RealTaseny/lidar_camera_sync_hardware/3D_Models/SPM7054VT-100M-D.step

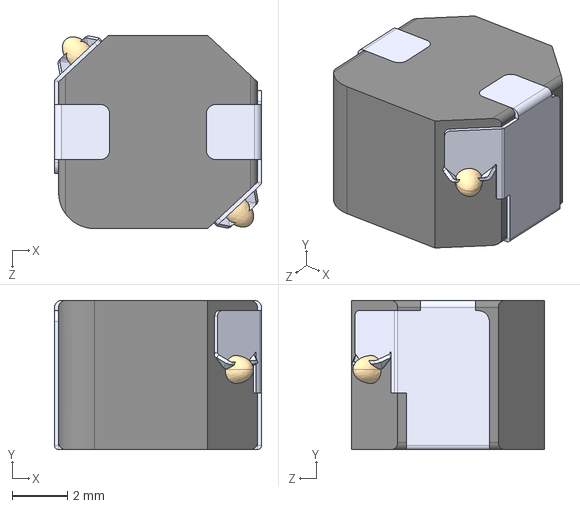
[picture p1: CAD file, 2025-11-24]
3D_Models/SPM7054VT-100M-D.step
7.50 x 5.40 x 7.00 mm
