RealTaseny/lidar_camera_sync_hardware/3D_Models/AMS1117-5.0.step

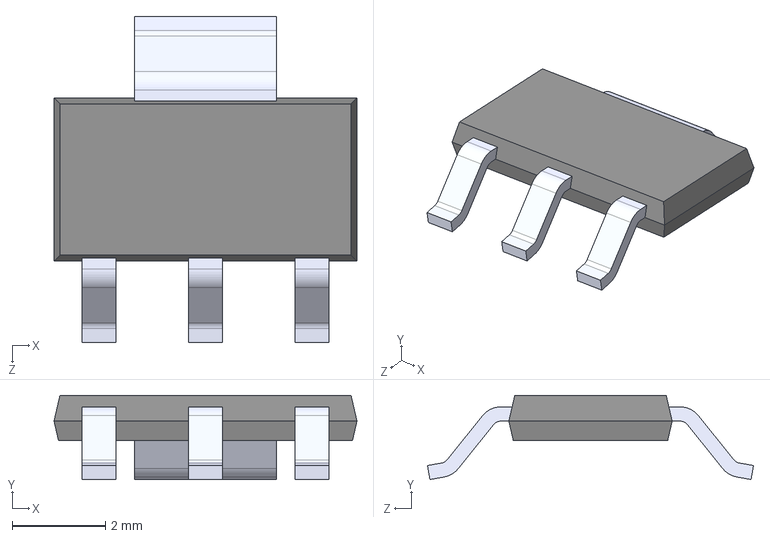
[picture p2: CAD file, 2025-11-24]
3D_Models/AMS1117-5.0.step
6.50 x 1.80 x 7.00 mm
