RealTaseny/lidar_camera_sync_hardware/3D_Models/BM08B-GHS-TBT_LF__SN__N_.step

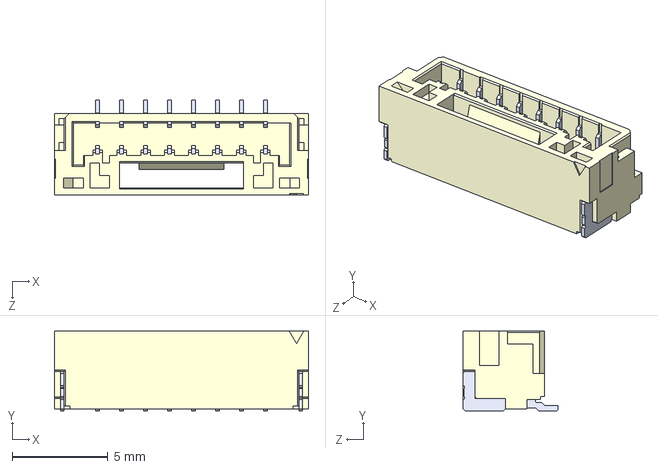
[picture p3: CAD file, 2025-11-24]
3D_Models/BM08B-GHS-TBT_LF__SN__N_.step
13.2 x 4.15 x 4.95 mm
