RealTaseny/lidar_camera_sync_hardware/3D_Models/RT9013-33GB.step

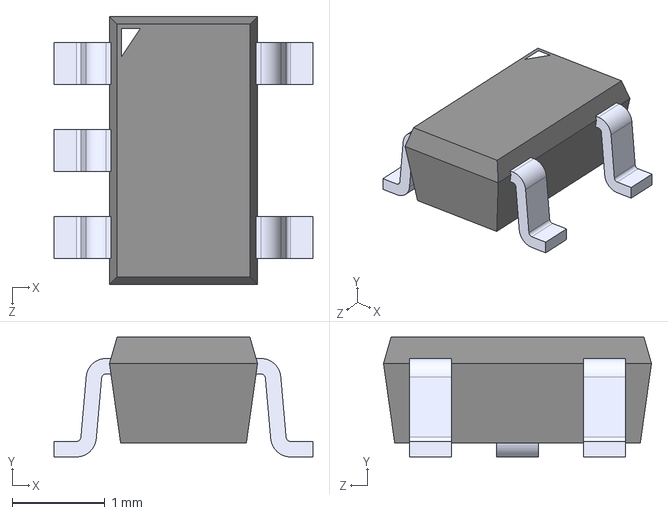
[picture p4: CAD file, 2025-11-24]
3D_Models/RT9013-33GB.step
2.79 x 1.30 x 2.90 mm
