RealTaseny/lidar_camera_sync_hardware/3D_Models/STM32G431KBU3.step

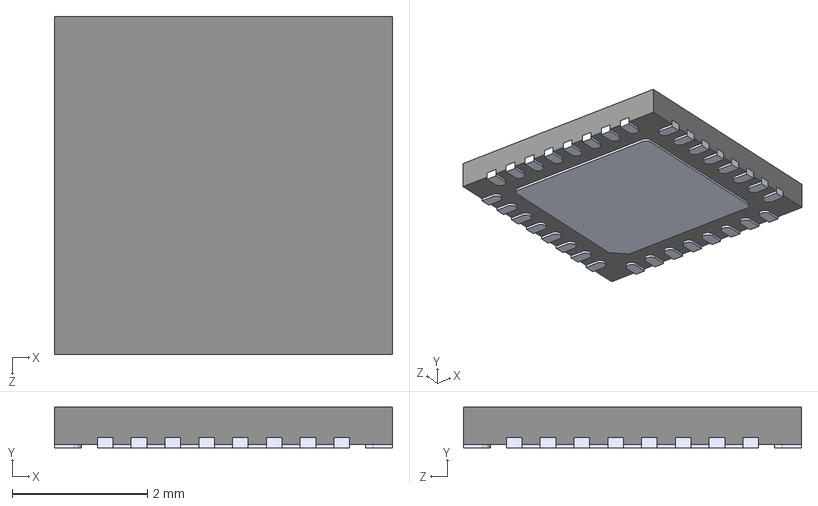
[picture p5: CAD file, 2025-11-24]
3D_Models/STM32G431KBU3.step
5.00 x 0.6 x 5.00 mm
