RealTaseny/lidar_camera_sync_hardware/3D_Models/TS-1088-AR02016.step

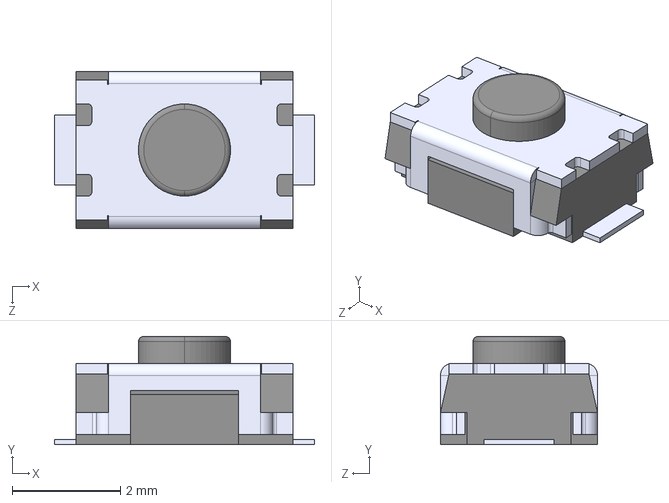
[picture p6: CAD file, 2025-11-24]
3D_Models/TS-1088-AR02016.step
4.80 x 2.00 x 2.90 mm
