RealTaseny/lidar_camera_sync_hardware/3D_Models/MAX3232ESE.step

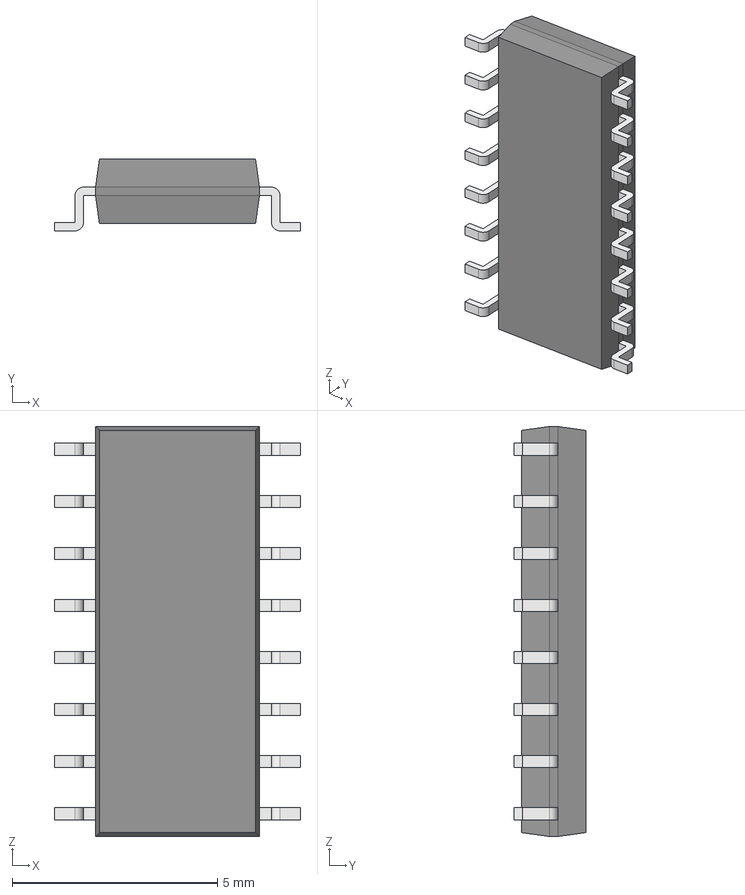
[picture p7: CAD file, 2025-11-24]
3D_Models/MAX3232ESE.step
6.00 x 1.75 x 10.0 mm
Body001 (Mirror #1) x 8
XY-plane x 12
X-axis x 12
