RealTaseny/lidar_camera_sync_hardware/3D_Models/TPS54560DDAR.step

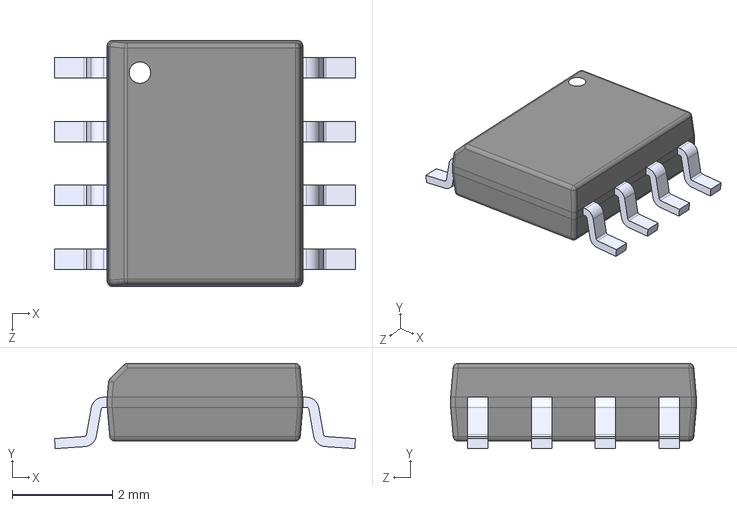
[picture p8: CAD file, 2025-11-24]
3D_Models/TPS54560DDAR.step
6.00 x 1.70 x 4.90 mm
