RealTaseny/lidar_camera_sync_hardware/3D_Models/ISO7720D.step

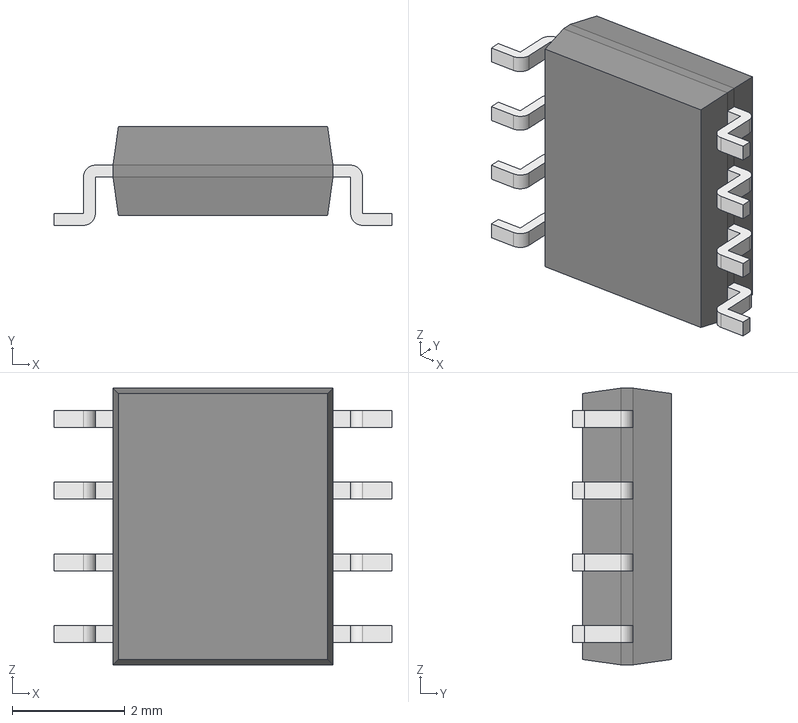
[picture p9: CAD file, 2025-11-24]
3D_Models/ISO7720D.step
5.99 x 1.75 x 4.91 mm
Body001 (Mirror #1) x 4
XY-plane x 12
X-axis x 12
