RealTaseny/lidar_camera_sync_hardware/3D_Models/X32258MOB4SI.step

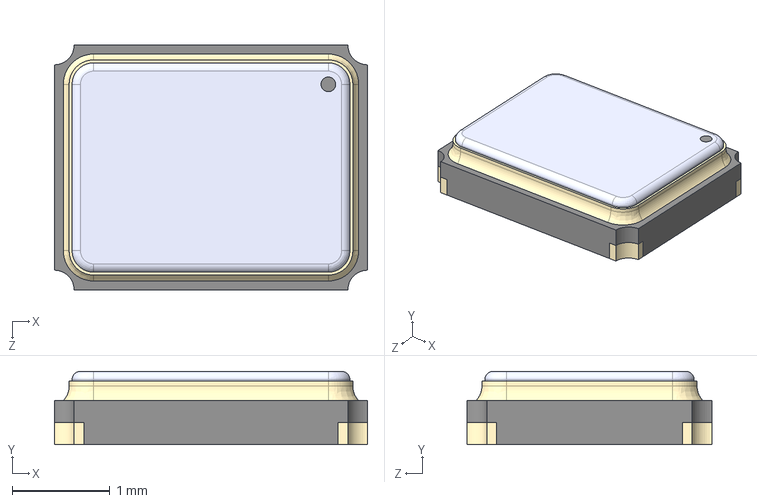
[picture p10: CAD file, 2025-11-24]
3D_Models/X32258MOB4SI.step
3.20 x 0.75 x 2.50 mm
