RealTaseny/lidar_camera_sync_hardware/lidar_camera_sync.kicad_pcb

## KiCad design lidar_camera_sync.kicad_pcb (2025-11-25)

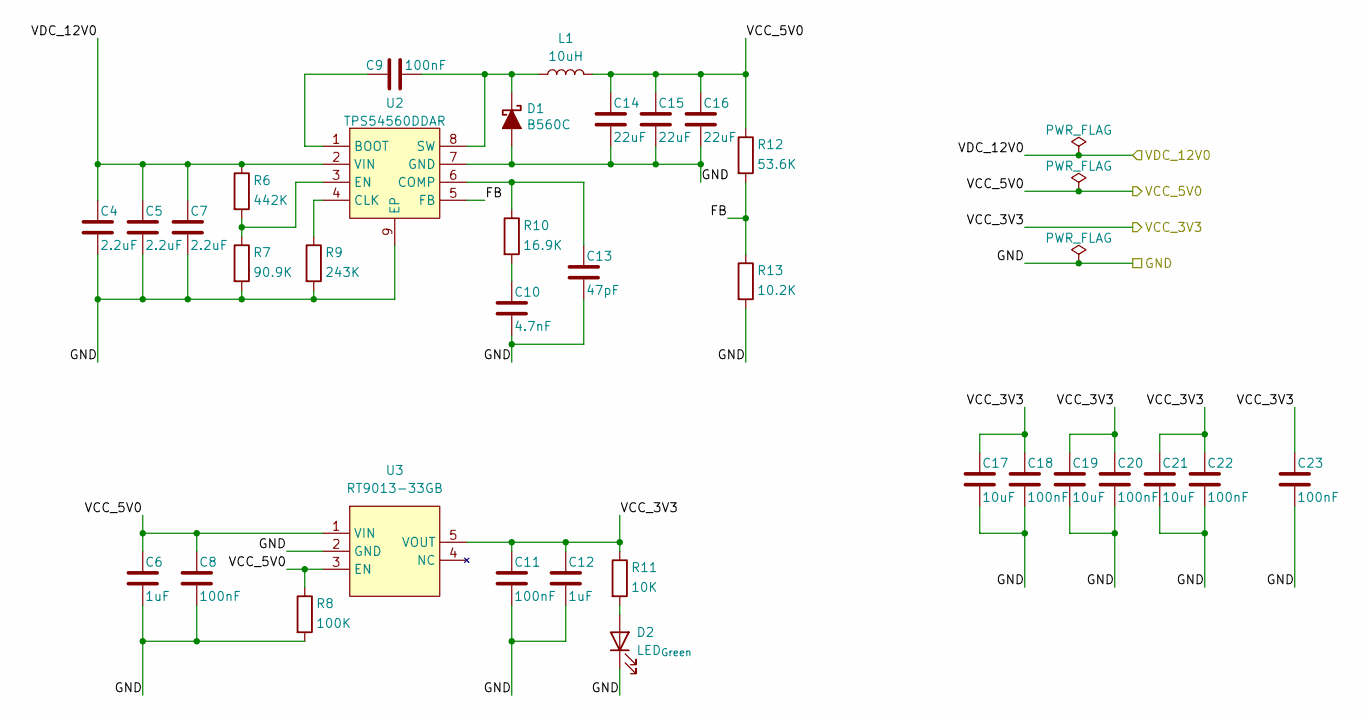
[picture p11: schematic Power.kicad_sch]

Parts:
C4, C5, C7: 2.2uF; C_0805_2012Metric
C6, C12: 1uF; C_0603_1608Metric
C8, C9, C11, C18, C20, C22, C23: 100nF; C_0603_1608Metric
C10: 4.7nF; C_0603_1608Metric
C13: 47pF; C_0603_1608Metric
C14, C15, C16: 22uF; C_0805_2012Metric
C17, C19, C21: 10uF; C_0603_1608Metric
D1: B560C; D_SMC
D2: LED_{Green}; LED_0603_1608Metric
L1: 10uH; SPM7054VT-100M-D
R6: 442K; R_0603_1608Metric
R7: 90.9K; R_0603_1608Metric
R8: 100K; R_0603_1608Metric
R9: 243K; R_0603_1608Metric
R10: 16.9K; R_0603_1608Metric
R11: 10K; R_0603_1608Metric
R12: 53.6K; R_0603_1608Metric
R13: 10.2K; R_0603_1608Metric
U2: TPS54560DDAR; SOIC8-4.9x5.4_P1.27
U3: RT9013-33GB; SOT-23-5

Connections:
/MCU/GND: C4.2, C5.2, C6.2, C7.2, C8.2, C10.2, C11.2, C12.2, C13.2, C14.2, C15.2, C16.2, C17.2, C18.2, C19.2, C20.2, C21.2, C22.2, C23.2, D1.2 (A), D2.1 (K), R7.2, R8.2, R9.2, R13.2, U2.7 (GND), U2.9 (EP), U3.2 (GND); also elsewhere on the board
/MCU/VCC_3V3: C11.1, C12.1, C17.1, C18.1, C19.1, C20.1, C21.1, C22.1, C23.1, R11.1, U3.5 (VOUT); also elsewhere on the board
/Peripheral/12V_CAMERA: C4.1, C5.1, C7.1, R6.1, U2.2 (VIN); also elsewhere on the board
/Peripheral/VCC_5V0: C6.1, C8.1, C14.1, C15.1, C16.1, L1.2, R8.1, R12.1, U3.1 (VIN), U3.3 (EN); also elsewhere on the board
/Power/FB: R12.2, R13.1, U2.5 (FB)
unnamed: C10.1, R10.2
unnamed: C9.2, D1.1 (K), L1.1, U2.8 (SW)
unnamed: D2.2 (A), R11.2
unnamed: C9.1, U2.1 (BOOT)
unnamed: R9.1, U2.4 (CLK)
unnamed: C13.1, R10.1, U2.6 (COMP)
unnamed: R6.2, R7.1, U2.3 (EN)

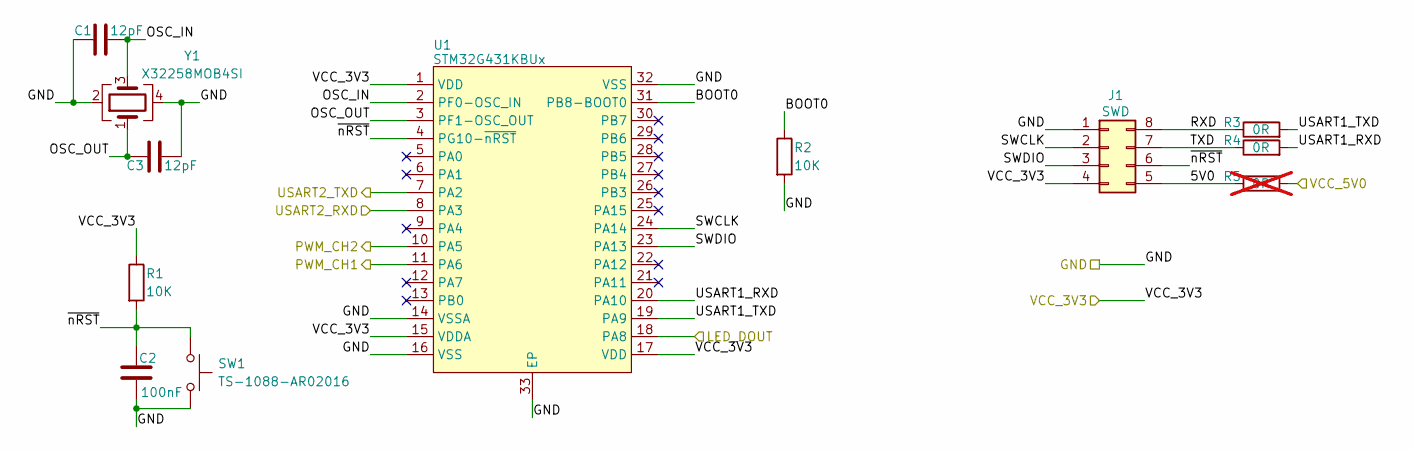
[picture p12: schematic MCU.kicad_sch]

Parts:
C1, C3: 12pF; C_0603_1608Metric
C2: 100nF; C_0603_1608Metric
J1: SWD; Pinheader_2x04_P2.54mm
R1, R2: 10K; R_0603_1608Metric
R3, R4: 0R; R_0603_1608Metric
R5: 0R; R_0603_1608Metric; not fitted
SW1: TS-1088-AR02016
U1: STM32G431KBUx; UFQFPN32-5.3x5.3_P0.5
Y1: X32258MOB4SI; SMD3225

Connections:
/MCU/5V0: J1.5, R5.1; also elsewhere on the board
/MCU/BOOT0: R2.1, U1.31 (PB8-BOOT0)
/MCU/GND: C1.2, C2.2, C3.1, J1.1, R2.2, SW1.2, U1.14 (VSSA), U1.16 (VSS), U1.32 (VSS), U1.33 (EP), Y1.2, Y1.4; also elsewhere on the board
/MCU/LED_DOUT: U1.18 (PA8); also elsewhere on the board
/MCU/OSC_IN: C1.1, U1.2 (PF0-OSC_IN), Y1.3
/MCU/OSC_OUT: C3.2, U1.3 (PF1-OSC_OUT), Y1.1
/MCU/PWM_CH1: U1.11 (PA6); also elsewhere on the board
/MCU/PWM_CH2: U1.10 (PA5); also elsewhere on the board
/MCU/RXD: J1.8, R3.1; also elsewhere on the board
/MCU/SWCLK: J1.2, U1.24 (PA14); also elsewhere on the board
/MCU/SWDIO: J1.3, U1.23 (PA13); also elsewhere on the board
/MCU/TXD: J1.7, R4.1; also elsewhere on the board
/MCU/USART1_RXD: R4.2, U1.20 (PA10)
/MCU/USART1_TXD: R3.2, U1.19 (PA9)
/MCU/USART2_RXD: U1.8 (PA3); also elsewhere on the board
/MCU/USART2_TXD: U1.7 (PA2); also elsewhere on the board
/MCU/VCC_3V3: J1.4, R1.1, U1.1 (VDD), U1.15 (VDDA), U1.17 (VDD); also elsewhere on the board
/MCU/~nRST: C2.1, J1.6, R1.2, SW1.1, U1.4 (PG10-~nRST); also elsewhere on the board
/Peripheral/VCC_5V0: R5.2; also elsewhere on the board

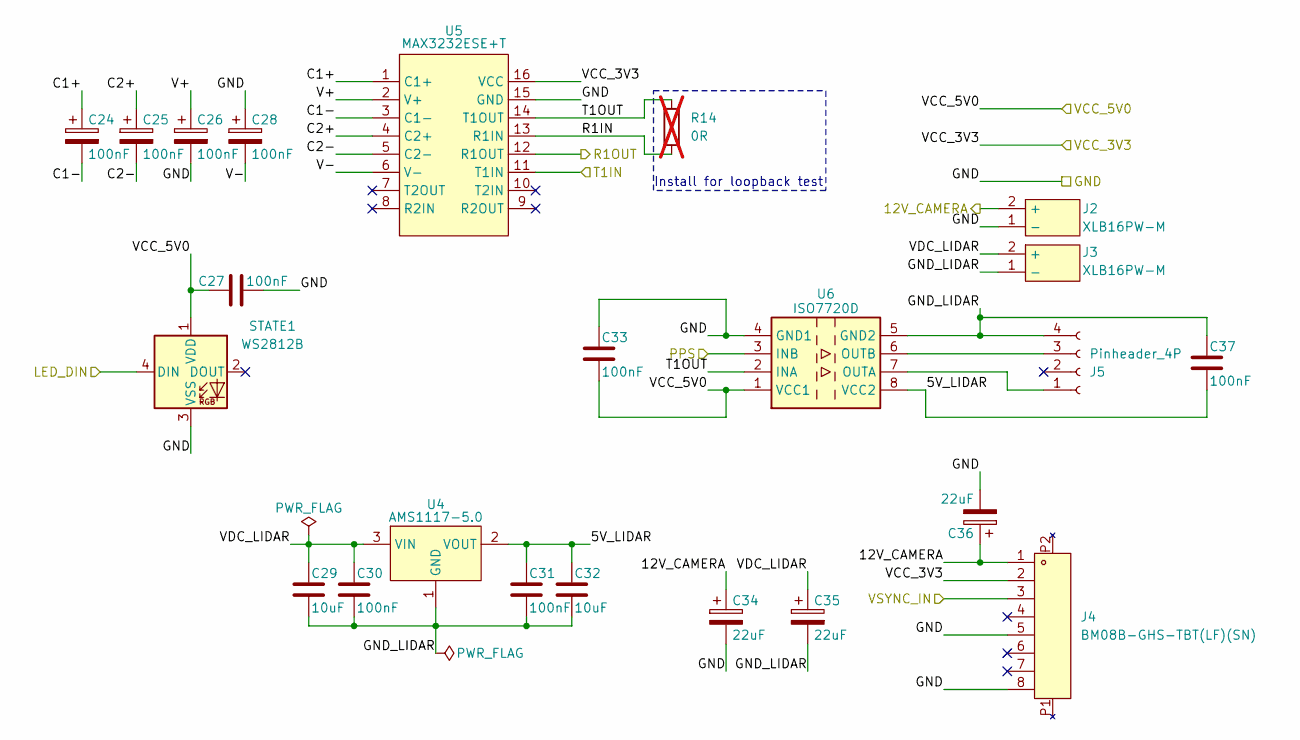
[picture p13: schematic Peripheral.kicad_sch]

Parts:
C24, C25, C26, C28: 100nF; CP_Elec_4x5.4
C27, C30, C31, C33, C37: 100nF; C_0603_1608Metric
C29, C32: 10uF; C_0603_1608Metric
C34, C35, C36: 22uF; CP_Elec_6.3x5.4
J2, J3: XLB16PW-M
J4: BM08B-GHS-TBT(LF)(SN); BM08B-GHS-TBT(LF)(SN)(N)
J5: Pinheader_4P; PinHeader_1x04_P2.54mm_Vertical
R14: 0R; R_0603_1608Metric; not fitted
STATE1: WS2812B; LED_WS2812B_PLCC4_5.0x5.0mm_P3.2mm
U4: AMS1117-5.0; SOT223
U5: MAX3232ESE+T; SOIC16-4.95x8.9_P1.27
U6: ISO7720D; SOIC8-4.9x5.4_P1.27_NO_EP

Connections:
/MCU/GND: C26.2, C27.2, C28.1, C33.1, C34.2, C36.2, J2.1 (-), J4.5, J4.8, STATE1.3 (VSS), U5.15 (GND), U6.4 (GND1); also elsewhere on the board
/MCU/PWM_CH1: U6.3 (INB); also elsewhere on the board
/MCU/PWM_CH2: J4.3; also elsewhere on the board
/MCU/USART2_RXD: U5.12 (R1OUT); also elsewhere on the board
/MCU/USART2_TXD: U5.11 (T1IN); also elsewhere on the board
/MCU/VCC_3V3: J4.2, U5.16 (VCC); also elsewhere on the board
/Peripheral/5V_LIDAR: C31.1, C32.1, C37.2, U4.2 (VOUT), U4.4 (VOUT), U6.8 (VCC2)
/Peripheral/12V_CAMERA: C34.1, C36.1, J4.1; also elsewhere on the board
/Peripheral/C1+: C24.1, U5.1 (C1+)
/Peripheral/C1-: C24.2, U5.3 (C1-)
/Peripheral/C2+: C25.1, U5.4 (C2+)
/Peripheral/C2-: C25.2, U5.5 (C2-)
/Peripheral/GND_LIDAR: C29.2, C30.2, C31.2, C32.2, C35.2, C37.1, J3.1 (-), J5.4, U4.1 (GND), U6.5 (GND2); also elsewhere on the board
/Peripheral/R1IN: R14.2, U5.13 (R1IN)
/Peripheral/T1OUT: R14.1, U5.14 (T1OUT), U6.2 (INA)
/Peripheral/V+: C26.1, U5.2 (V+)
/Peripheral/V-: C28.2, U5.6 (V-)
/Peripheral/VCC_5V0: C27.1, C33.2, STATE1.1 (VDD), U6.1 (VCC1); also elsewhere on the board
/Peripheral/VDC_LIDAR: C29.1, C30.1, C35.1, J3.2 (+), U4.3 (VIN); also elsewhere on the board
unnamed 35: J5.1, U6.7 (OUTA); also elsewhere on the board
unnamed 36: J5.3, U6.6 (OUTB); also elsewhere on the board

Notes on the sheet:
Install for loopback test

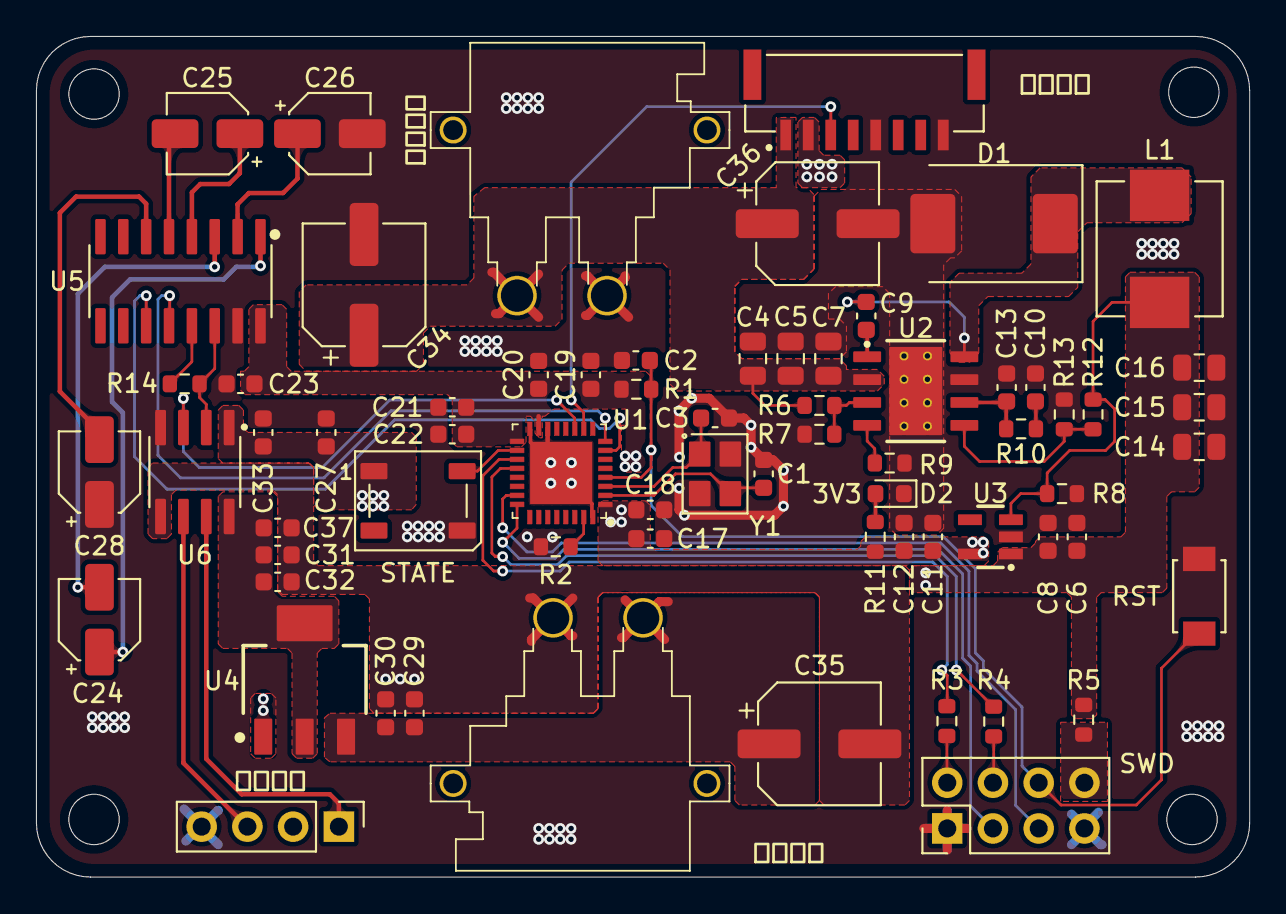
[picture p14: board lidar_camera_sync.kicad_pcb from above]

Board: 2 copper layers, 67.4 x 46.7 mm, 68 parts (0 on the bottom side), 41 nets.

Other parts of the board:
RST: TS-1088-AR02016
STATE: WS2812B; LED_WS2812B_PLCC4_5.0x5.0mm_P3.2mm
SWD: SWD; Pinheader_2x04_P2.54mm
相机电源: XLB16PW-M
雷达接口: Pinheader_4P; PinHeader_1x04_P2.54mm_Vertical
雷达电源: XLB16PW-M

Their connections:
/MCU/5V0: SWD.5; also elsewhere on the board
/MCU/GND: RST.2, STATE.3 (VSS), SWD.1, 相机电源.1 (-); also elsewhere on the board
/MCU/LED_DOUT: STATE.4 (DIN); also elsewhere on the board
/MCU/RXD: SWD.8; also elsewhere on the board
/MCU/SWCLK: SWD.2; also elsewhere on the board
/MCU/SWDIO: SWD.3; also elsewhere on the board
/MCU/TXD: SWD.7; also elsewhere on the board
/MCU/VCC_3V3: SWD.4; also elsewhere on the board
/MCU/~nRST: RST.1, SWD.6; also elsewhere on the board
/Peripheral/12V_CAMERA: 相机电源.2 (+); also elsewhere on the board
/Peripheral/GND_LIDAR: 雷达接口.4, 雷达电源.1 (-); also elsewhere on the board
/Peripheral/VCC_5V0: STATE.1 (VDD); also elsewhere on the board
/Peripheral/VDC_LIDAR: 雷达电源.2 (+); also elsewhere on the board
unnamed 35: 雷达接口.1; also elsewhere on the board
unnamed 36: 雷达接口.3; also elsewhere on the board
