RealTaseny/lidar_camera_sync_hardware/(commit log)

2025-11-22 [New]: 完成MCU部分电路原理图\JIRA-ID: N/A\完成MCU部分原理图绘制以及部分Power部分原理图绘制
    [MCU.kicad_sch, Peripheral.kicad_sch, Power.kicad_sch, lidar_camera_sync.kicad_sch]
2025-11-23 [New]: 完成整个原理图绘制和ERC检查
    JIRA-ID: N/A
    完成整个原理图绘制和ERC检查
    [MCU.kicad_sch, Peripheral.kicad_sch, Power.kicad_sch, lidar_camera_sync.kicad_sch]
2025-11-24 [Fix]: 添加雷达供电隔离
    添加雷达信号隔离电路，检查原理图错误，新增原理图符号
    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
    [MCU.kicad_sch, Peripheral.kicad_sch, lidar_camera_sync.kicad_sch]
2025-11-24 [New]: 添加封装
    添加除电阻电容外的封装和3D模型
    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
    [AMS1117-5.0.step, BM08B-GHS-TBT_LF__SN__N_.step, ISO7720D.step, MAX3232ESE.step, RT9013-33GB.step, STM32G431KBU3.step, TPS54560DDAR.step, TS-1088-AR02016.step]
2025-11-24 [Fix]: 添加漏掉的提交
    添加漏掉的提交
    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
2025-11-24 [Modify]: 完成封装的分配和PCB更新
    完成封装的分配和从原理图到PCB的初始更新;完成DRC检查
    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
    [MCU.kicad_sch, Peripheral.kicad_sch, Power.kicad_sch, SPM7054VT-100M-D.step, lidar_camera_sync.kicad_pcb]
2025-11-25 [Modify]: 添加输入输出去耦电容以及WS2812B灯珠
    添加输入输出去耦电容以及WS2812B灯珠
    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
    [MCU.kicad_sch, Peripheral.kicad_sch, Power.kicad_sch, lidar_camera_sync.kicad_sch]
2025-11-25 [Modify]: 修复一些封装错误, 完成基本Layout器件摆放
    修复一些封装错误, 完成基本Layout器件摆放
    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
    [MCU.kicad_sch, Peripheral.kicad_sch, lidar_camera_sync.kicad_pcb]
2025-11-25 [New]: 完成PCB编辑以及DRC设计检查
    完成PCB编辑以及DRC设计检查, 等待打板验证以及导出BOM表
    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
    [lidar_camera_sync.kicad_pcb]
2025-11-25 [New]: 生成嘉立创打板文件和BOM表
    生成嘉立创打板文件和BOM表
    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
    [bom.csv, designators.csv, lidar_camera_sync.kicad_pcb, positions.csv]
